gfriloux/jardin/docs/src/content/docs/objectifs/o5-chaine-de-donnees.md

---
title: O5 — La chaîne de données
description: De la liaison série à Grafana, en passant par une archive brute et MariaDB.
sidebar:
  order: 5
  badge:
    text: Prêt
    variant: note
---

**La question.** Est-ce que l'architecture de données est agréable à exploiter ?

**Critère de sortie.** Quatre choses, toutes vérifiables en une séance :

1. une trame partie de la radio arrive dans Grafana, rattachée à son point de
   mesure et à sa zone ;
2. l'index se reconstruit **entièrement** depuis l'archive par simple réimport ;
3. la chaîne survit à ce qui va lui arriver — nœud muet, ligne d'archive
   illisible, collecteur relancé, changement de mois ;
4. les quatre questions ouvertes ci-dessous sont tranchées.

**Dépend de.** [O3](/objectifs/o3-calibration/) et
[O4](/objectifs/o4-lien-radio/) · **Débloque.**
[O6](/objectifs/o6-autonomie/)

:::note[Le critère demandait « une semaine de mesures ». Il ne le demande plus]
La formulation initiale datait d'avant que la chaîne existe : une semaine de
données servait de preuve indirecte que tout tenait ensemble. Maintenant que
tout a tourné, elle ne prouverait plus grand-chose.

**Ce que la semaine aurait apporté** tient en trois points, et aucun ne vaut
sept jours : que le collecteur tienne dans la durée — 48 h le montrent aussi
bien ; la bascule de fichier d'archive au changement de mois — qui arrive de
toute façon ; et du volume — dont MariaDB ne s'apercevra pas.

**Ce qu'elle n'aurait pas apporté**, en revanche, est précisément ce que O5
cherche. Les sondes sont sur une table, l'une dans un verre d'eau : une semaine
de ça produit une ligne plate, et on n'exploite pas une ligne plate. La question
« cette architecture est-elle agréable à exploiter » a besoin de données qui
disent quelque chose, pas de données nombreuses.

**La semaine de mesures réelles est donc déplacée dans
[O7](/objectifs/o7-mise-au-jardin/)**, où les sondes seront en terre. Elle n'y
coûte rien de plus — c'est ce que O7 fait de toute façon — et elle y produira
enfin une courbe d'assèchement, qui est ce dont [O8](/objectifs/o8-exploitation/)
a besoin.

Reste que les quatre questions ouvertes de cet objectif sont toutes des
questions de **conception**, et qu'aucune ne se répond en attendant.
:::

## La chaîne

```mermaid
flowchart LR
    N["NODE-001"] -->|LoRa| G["GATEWAY-001"]
    G -->|USB série| C["collecteur<br/>(Rust)"]
    C -->|append-only| F["data/*.ndjson<br/><b>source de vérité</b>"]
    F --> I["importeur<br/>(même binaire)"]
    I --> DB["MariaDB"]
    DB --> V["Grafana"]
```

Le point important est le **découplage par l'archive** : le nœud ne sait rien
du serveur, le collecteur ne sait rien de SQL, et la base ne sait rien de LoRa.
Chacun peut être remplacé sans toucher aux autres.

L'archive est le point de synchronisation, et elle est la seule pièce dont la
perte serait irréparable.

## Le collecteur

Un binaire Rust — voir [ADR-006](/decisions/#adr-006--collecteur-en-rust) — avec
deux sous-commandes, et des responsabilités volontairement étroites.

`collect` :

1. lire les lignes de `GATEWAY-001` sur le port série ;
2. **horodater** à la réception (le nœud n'a pas d'horloge fiable) ;
3. écrire en append-only dans `data/AAAA-MM/NODE-XXX.ndjson`.

C'est tout. Il ne connaît ni SQL ni MQTT : il sait écrire des lignes.

`import` :

4. relire l'archive et alimenter MariaDB, de façon **idempotente** — rejouer
   toute l'archive ne crée aucun doublon.

La calibration n'est appliquée nulle part : elle est calculée à la lecture par
une vue SQL. Voir [ADR-012](/decisions/#adr-012--larchive-ndjson-est-le-bus-mqtt-sort-du-chemin-principal).

### `collect` ne comprend pas ce qu'il transporte

C'est délibéré, et c'est le point de conception le plus important du collecteur.
Il valide que la ligne est du JSON, en extrait `frame.node` pour choisir le
fichier, et **recopie tout le reste sans l'interpréter**. Le jour où le firmware
ajoutera un champ, celui-ci traversera l'archive intact au lieu d'être
silencieusement perdu.

Trois propriétés qui en découlent, toutes vérifiées par des tests :

- les entiers restent entiers — `1834`, jamais `1834.0` ;
- le bruit de démarrage de la carte (`ets Jul 29 2019…`) est signalé et ignoré,
  sans interrompre la collecte ;
- le nom du nœud est **filtré avant de servir de nom de fichier**. Le nœud
  contrôle cette chaîne : une trame annonçant `"node": "../../etc/cron.d/x"`
  ferait sinon écrire le collecteur hors de son répertoire.

Chaque ligne est vidée sur disque immédiatement. À quelques trames par minute,
le coût est nul, et une coupure de courant ne fait pas perdre le tampon.

### `import` est rejouable

Deux mécanismes complémentaires :

- un **repère d'avancement** par fichier (`import_state`), pour reprendre où on
  s'est arrêté plutôt que de tout relire ;
- l'**unicité de `(source_file, source_line)`**, qui garantit qu'une ligne déjà
  connue ne peut pas être insérée deux fois, même si le repère est faux.

`--rejouer` efface les repères et relit toute l'archive : l'opération est sans
effet de bord, et c'est ce qui rend la base jetable.

Un nœud inconnu est **créé automatiquement**, avec un libellé explicite. Refuser
la trame ferait perdre des mesures parce que le matériel n'a pas encore été
déclaré ; `v_current_wiring` montrera ses voies sans sonde attachée, ce qui est
le rappel qu'il reste à le faire.

### D'où vient le type d'une mesure

La trame ne le transporte pas : le nœud émet `"soil-01": 1834`, sans dire ce que
c'est. La table `channel_convention` fait la correspondance par préfixe, le plus
long l'emportant :

```text
soil-      → soil_moisture / raw
soiltemp-  → soil_temperature / degC
battery    → voltage / V
```

Déclaratif plutôt que codé en dur : ajouter un type ne demande pas de
recompiler. Et indépendant des déclarations de matériel, donc les mesures
rentrent même avant qu'on ait déclaré quoi que ce soit.

## Le contrôle de fin d'objectif

```console
$ just db-wiring
+----------+---------+--------------------------+------------------+-----------+----------+
| node_uid | channel | point_label              | measurement_type | zone_uid  | depth_cm |
+----------+---------+--------------------------+------------------+-----------+----------+
| NODE-001 | soil-01 | Fraisiers — humidité 1   | soil_moisture    | FRAISIERS |     NULL |
| NODE-001 | soil-02 | Fraisiers — humidité 2   | soil_moisture    | FRAISIERS |     NULL |
| NODE-001 | soil-03 | Fraisiers — humidité 3   | soil_moisture    | FRAISIERS |     NULL |
+----------+---------+--------------------------+------------------+-----------+----------+
```

Trois voies, trois libellés, une zone — et les mesures qui s'y rattachent dans
Grafana comme dans l'archive. `depth_cm` reste vide tant que rien n'est en
terre : c'est [O7](/objectifs/o7-mise-au-jardin/) qui le remplira.

## Le simulateur de nœud

Écrit avant le collecteur, et volontairement : il permet d'éprouver toute la
chaîne serveur **sans matériel**.

```console
$ just sim-serie        # un port série virtuel sur /tmp/jardin-gateway
$ just sim-archive 21   # trois semaines d'historique dans l'archive
```

Le but n'est pas de jouer, c'est de **découpler les pannes**. Si la chaîne
serveur est prouvée avec des données synthétiques, alors le jour où le matériel
arrive, ce qui casse est forcément le matériel ou le firmware — on ne débogue
plus deux inconnues à la fois, une carte neuve dans les mains.

Il reproduit ce qu'on cherchera réellement à observer, plutôt que des nombres au
hasard :

| Phénomène | Pourquoi il compte |
|---|---|
| Assèchement exponentiel, arrosages espacés | la forme des courbes de [O8](/objectifs/o8-exploitation/) |
| **Dispersion inter-sondes** (±8 % sur les bornes sec/saturé) | reproduit la découverte que [O3](/objectifs/o3-calibration/) doit faire |
| Effet de profondeur : la couche à 20 cm réagit moins et plus tard | l'observation qui motive deux profondeurs par zone |
| Oscillation thermique jour/nuit | l'effet qui justifiera une sonde de température |
| Trames perdues, trous dans `seq` | de quoi mesurer un taux de perte |
| Lignes parasites de démarrage (`ets Jul 29 2019…`) | ce qui fait planter un parseur naïf |
| Redémarrages, `seq` qui repart à 0 | à détecter côté collecteur |

Une implémentation **indépendante** du collecteur, en Python : elle ne partage
pas ses hypothèses, ce qui est précisément ce qui rend le test valable.

Les parasites n'existent que sur la liaison série — l'archive, elle, ne contient
que des trames valides. C'est une propriété du collecteur, et le simulateur la
respecte pour ne pas donner un faux sentiment de robustesse à l'importeur.

## Le tableau de bord

Provisionné par fichier — `stack/grafana/provisioning/dashboards/` — donc
versionné avec le reste. Il apparaît tout seul au démarrage de la stack, sans
rien cliquer.

Six panneaux, chacun répondant à la question d'un objectif :

| Panneau | Ce qu'il sert à voir |
|---|---|
| **Nœuds** | âge de la dernière trame, taux de perte, RSSI, batterie. Une ligne par carte |
| **Valeur brute d'ADC** | ce qui est réellement stocké. La valeur **descend** quand l'humidité monte |
| **Humidité calibrée** | la même chose interprétée. Reste vide tant que [O3](/objectifs/o3-calibration/) n'a pas produit de calibration |
| **Écart entre sondes de même profondeur** | la question de O3 : ce qui reste après regroupement par profondeur est la dispersion propre des sondes |
| **Qualité du lien radio** | RSSI et SNR, pour [O4](/objectifs/o4-lien-radio/) et [O7](/objectifs/o7-mise-au-jardin/) |
| **Tension d'alimentation** | peu informative sur powerbank, elle le deviendra à [O6](/objectifs/o6-autonomie/) |

Le taux de perte est estimé par les trous dans le compteur de séquence, **en
excluant les redémarrages** — un `seq` qui repart à 0 n'est pas une perte.

:::caution[Le fuseau horaire, piège silencieux]
Le collecteur horodate en UTC et les colonnes `DATETIME` ne portent pas de
fuseau. La source de données Grafana doit donc annoncer **`timezone: UTC`** :
y mettre `Europe/Paris` décale tout l'historique de deux heures en été, sans
aucun message d'erreur. L'affichage dans le fuseau local est le travail du
tableau de bord, pas de la source de données.
:::

**Pour expérimenter** : le fichier fait foi, l'interface ne peut pas
l'écraser. « Save as » crée une copie où tinkerer librement ; ce qui mérite
d'être gardé se reporte dans le JSON versionné.

## Pourquoi une archive en plus de la base

Une ligne JSON par trame, jamais réécrite, dans le format le plus bête possible.
C'est précisément parce qu'il est bête qu'il survivra à tous les changements de
base de données.

La base sert à **regarder et interroger**. L'archive sert à **survivre** : elle
permet de reconstruire l'index de zéro, et de rejouer tout l'historique après un
changement de calibration.

## La stack

Base, visualisation, collecteur et importeur sont décrits dans un seul
`stack/compose.yaml` — voir
[ADR-011](/decisions/#adr-011--la-stack-serveur-est-un-jeu-de-conteneurs).

```console
$ just stack-up            # MariaDB + Grafana
$ just db-wiring           # quelle sonde est branchée où
```

Grafana écoute alors sur `http://localhost:3000`, avec sa source de données déjà
provisionnée. Le collecteur et l'importeur s'ajoutent avec
`just stack-up-collector` quand ils existeront — un profil Compose les tient à
l'écart d'ici là, comme Home Assistant, conservé sous le profil `ha` pour
[O9](/objectifs/o9-irrigation/).

L'intérêt de cette forme est qu'elle ne préjuge pas de la machine : le même
fichier tournera sur le poste aujourd'hui, sur un Raspberry Pi cet hiver. La
question « où héberger » devient un choix d'exploitation, pas d'architecture.

:::caution[Le port série dans un conteneur]
C'est la seule vraie contrainte que la conteneurisation introduit. Le
collecteur a besoin de `devices:` sur la passerelle USB — et surtout d'un **nom
de périphérique stable**, sans quoi `/dev/ttyUSB0` devient `/dev/ttyUSB1` au
premier rebranchement et le conteneur refuse de démarrer. La règle udev est
dans `stack/README.md`.
:::

Conséquence assumée pendant le POC : pas de mesures quand le poste est éteint.

## Questions ouvertes

- L'importeur doit-il tourner en continu (`--follow`) ou par lot périodique ?
- Comment détecter proprement qu'un nœud est muet — un délai fixe, ou un
  multiple de sa période d'émission annoncée ?
- Que fait l'importeur d'une ligne d'archive illisible : il l'ignore et
  poursuit, ou il s'arrête ?
- Faut-il un tableau de bord Grafana provisionné par fichier, ou construit à la
  main puis exporté ?

## Résultats

*À remplir.*
