gfriloux/jardin/docs/src/content/docs/projet/feuille-de-route.md

---
title: Feuille de route
description: Le graphe des dix objectifs, du premier octet lu sur l'ADC jusqu'aux électrovannes.
sidebar:
  order: 2
---

Le projet avance par **objectifs numérotés**. Chacun a un critère de sortie
vérifiable : tant qu'il n'est pas atteint, on n'attaque pas le suivant. Un
objectif n'est pas une liste de tâches, c'est une **question à laquelle on veut
une réponse**.

## Le graphe

```mermaid
flowchart TD
    O0["<b>O0 — Socle projet</b><br/>dépôt, devshell Nix, doc"]
    O1["<b>O1 — Une sonde, une valeur</b><br/>ADC brut lisible sur la liaison série"]
    O2["<b>O2 — Passer à N sondes</b><br/>CD74HC4067, au-delà de quatre sondes"]
    O3["<b>O3 — Calibration</b><br/>sec / humide / saturé, dérive inter-sondes"]
    O4["<b>O4 — Le lien radio</b><br/>LoRa point-à-point NODE → GATEWAY"]
    O5["<b>O5 — La chaîne de données</b><br/>archive NDJSON → MariaDB → Grafana"]
    O6["<b>O6 — Autonomie</b><br/>deep sleep, conso, batterie, solaire"]
    O7["<b>O7 — Mise au jardin</b><br/>boîtier, câbles longs, portée réelle"]
    O8["<b>O8 — Exploitation</b><br/>courbes d'assèchement, seuils, alertes"]
    O9["<b>O9 — Irrigation</b><br/>électrovannes, boucle de commande"]

    O0 --> O1
    O1 --> O2
    O1 --> O3
    O3 -.->|référence de validation| O2
    O1 --> O4
    O4 --> O5
    O3 --> O5
    O5 --> O6
    O6 --> O7
    O7 --> O8
    O8 --> O9

    subgraph POC["POC — sur la table"]
        O1
        O2
        O3
        O4
        O5
    end
    subgraph V1["V1 — dehors, en permanence"]
        O6
        O7
        O8
    end
    subgraph V2["V2 — plus tard"]
        O9
    end
```

Trois choses à lire dans ce graphe :

- **O1 débloque O4 directement.** Le lien radio n'attend pas le multiplexage ni
  la calibration : une seule sonde suffit à valider la portée. Ces deux branches
  peuvent avancer en parallèle si le matériel le permet.
- **O3 ne dépend plus de O2**, et la flèche s'est même inversée en pointillés.
  ADC1 laisse quatre broches libres une fois la batterie et l'alimentation des
  sondes câblées : les trois sondes du POC tiennent en direct. Mesurer leur
  divergence *à travers* un multiplexeur empêcherait d'ailleurs de distinguer
  la dispersion des sondes de celle des canaux. Ces mesures directes sont au
  contraire la **référence contre laquelle O2 se validera** — c'est
  littéralement son critère de sortie.
- **O5 attend O3 *et* O4.** Stocker des mesures non calibrées est possible — et
  c'est même ce qu'on fait, la calibration étant calculée à la lecture. Mais on
  veut que la première série de données archivée soit déjà attribuable et
  interprétable.

## Les objectifs en une ligne

| # | Objectif | Question à laquelle il répond | État |
|---|---|---|---|
| [O0](/objectifs/o0-socle/) | Socle projet | Où vit le code, comment on le construit, où on documente ? | ✅ tenu |
| [O1](/objectifs/o1-une-sonde/) | Une sonde, une valeur | Est-ce qu'une sonde donne une valeur stable et plausible ? | ✅ tenu |
| [O2](/objectifs/o2-multiplexage/) | Passer à N sondes | Est-ce qu'un nœud peut lire plus de quatre sondes sans se mélanger ? | ✅ tenu |
| [O3](/objectifs/o3-calibration/) | Calibration | Que vaut réellement un nombre d'ADC ? | ✅ tenu |
| [O4](/objectifs/o4-lien-radio/) | Le lien radio | Est-ce que LoRa porte depuis le fond du jardin ? | ✅ tenu |
| [O5](/objectifs/o5-chaine-de-donnees/) | La chaîne de données | Est-ce que l'architecture de données est agréable à exploiter ? | 🔜 prêt |
| [O6](/objectifs/o6-autonomie/) | Autonomie | Combien de temps le nœud tient-il, et sur quelle source ? | ⏸ bloqué |
| [O7](/objectifs/o7-mise-au-jardin/) | Mise au jardin | Est-ce que ça survit dehors, avec 15 m de câble ? | ⏸ bloqué |
| [O8](/objectifs/o8-exploitation/) | Exploitation | Qu'est-ce que le sol raconte, et quand faut-il arroser ? | ⏸ bloqué |
| [O9](/objectifs/o9-irrigation/) | Irrigation | Peut-on fermer la boucle sans noyer les fraisiers ? | ⏸ bloqué |

## Les quatre questions du POC

Les objectifs O1 à O5 existent pour répondre à quatre questions, et à rien
d'autre :

1. ✅ Est-ce que les sondes donnent des mesures suffisamment **stables** ?
2. ✅ Est-ce qu'un nœud peut lire **plusieurs sondes** ? — seize canaux
   adressables, et un multiplexeur qui décale de moins de 2 points
3. ✅ Est-ce que **LoRa porte** correctement depuis le jardin ? — oui, et de
   très loin : 0 % de perte à 15 m, 60 dB de marge
   ([résultats](/objectifs/o4-lien-radio/#résultats))
4. ⬜ Est-ce que l'**architecture de données** est agréable à exploiter ?

Tout ce qui ne sert pas à répondre à l'une de ces quatre questions est du
travail reporté à la V1.

Trois des quatre sont donc closes. **La dernière est le seul chantier restant
du POC** : la chaîne a tourné de bout en bout, il lui reste à prouver qu'elle
encaisse les incidents — nœud muet, ligne d'archive illisible, collecteur
relancé.

## La progression du montage

Le nœud grossit par paliers, chacun correspondant à un objectif :

```mermaid
flowchart LR
    subgraph V00["V0.0 — O1"]
        A1[Heltec] --- A2[sonde 1]
    end
    subgraph V01["V0.1 — O3"]
        B1[Heltec] --- B3["S1 S2 S3<br/>en direct sur ADC1"]
    end
    subgraph V02["V0.2 — O4/O5"]
        C1["NODE-001<br/>mesure + seq + batterie"] -->|LoRa| C2[GATEWAY-001] -->|USB| C3[collecteur] -->|NDJSON| C4[MariaDB]
    end
    subgraph V03["V0.3 — O2"]
        D1[Heltec] --- D2[MUX] --- D3["jusqu'à 16 sondes"]
    end

    V00 --> V01 --> V02 --> V03
```

## Ce qui n'est pas dans le graphe

Trois chantiers transverses avancent en continu, sans objectif dédié :

- **la documentation** — chaque objectif atteint produit sa page ;
- **les décisions** — consignées au fil de l'eau dans les
  [ADR](/decisions/), y compris celles qu'on revient dessus ;
- **les mesures elles-mêmes** — dès O1, toute série de mesures est archivée,
  même celles ratées. Une sonde qui dérive est une donnée, pas un échec.
