gfriloux/jardin/docs/src/content/docs/projet/modele-de-donnees.md

---
title: Modèle de données
description: La trame radio, l'archive NDJSON et le schéma SQL — cartes LoRa, points de mesure, zones, et le câblage daté qui les relie.
sidebar:
  order: 4
---

## La chaîne

```mermaid
flowchart LR
    N["NODE-001<br/>trame LoRa"] -->|radio| G["GATEWAY-001"]
    G -->|USB série| C["collecteur"]
    C -->|append-only| A["archive NDJSON<br/><b>source de vérité</b>"]
    A --> I["importeur"]
    I --> DB["MariaDB<br/><i>index dérivé</i>"]
    DB --> V["Grafana"]
```

L'archive est le point de synchronisation. Le collecteur ne connaît ni SQL ni
MQTT : il sait écrire des lignes. L'importeur relit l'archive et alimente la
base — **rejouable de bout en bout**, ce qui rend la base jetable.

## Le tuple canonique

Tout ce qui traverse le système se réduit à :

```text
node_id  channel    timestamp             measurement_type  value   unit
─────────────────────────────────────────────────────────────────────────
NODE-001 soil-01    2026-08-20T12:00:00Z  soil_moisture     1834    raw
NODE-001 soil-02    2026-08-20T12:00:00Z  soil_moisture     1921    raw
NODE-001 battery    2026-08-20T12:00:00Z  voltage           4.87    V
```

La deuxième colonne est une **voie**, pas une sonde : `soil-01` est une prise
sur la carte, pas l'objet qui y est branché.

Le mot « humidité » n'apparaît **pas** dans le protocole. `soil_moisture` est
une valeur de `measurement_type` parmi d'autres, et son `unit` reste `raw` tant
qu'aucune calibration n'a été appliquée.

## Qui horodate

Le nœud **n'horodate pas**. Il n'a ni RTC ni source de temps fiable après un
deep sleep de plusieurs heures. Il émet un **compteur de séquence** monotone ;
le collecteur horodate à la réception et conserve `seq`, ce qui permet de
détecter a posteriori les paquets perdus et les redémarrages du nœud.

## La trame radio

Lisible, pour le POC :

```json
{
  "node": "NODE-001",
  "seq": 182,
  "battery": 4.87,
  "sensors": { "soil-01": 623, "soil-02": 581, "soil-03": 704 }
}
```

:::note[À réoptimiser plus tard]
LoRa impose un rapport cyclique (1 % en EU868 sur la plupart des sous-bandes) et
un temps d'antenne qui croît avec la taille du paquet. Une trame binaire compacte
deviendra nécessaire quand le nombre de nœuds augmentera — pas avant.
:::

## La distinction qui structure tout le schéma

Deux objets déclarés, et une chose qu'on ne déclare **pas** :

| Objet | Ce que c'est |
|---|---|
| **node** | une carte LoRa. Elle émet son identifiant. |
| **measurement_point** | une voie de mesure : ce qui est branché sur `NODE-001/soil-01`, comment ça s'appelle à l'écran, et dans quelle zone ça se trouve. |
| ~~sensor~~ | **rien.** La sonde n'est pas un objet suivi — voir [ADR-017](/decisions/#adr-017--on-déclare-des-points-de-mesure-pas-des-sondes). |

`NODE-001/soil-01` et `NODE-002/soil-01` sont deux voies différentes, et chacune
peut changer de zone ou de rôle dans le temps. D'où une **table datée** plutôt
qu'une clé étrangère directe.

```mermaid
erDiagram
    node ||--o{ measurement_point : "porte"
    zone ||--o{ measurement_point : "contient"
    measurement_point ||--o{ calibration : "est calibré par"
    node ||--o{ frame : "émet"
    frame ||--o{ measurement : "porte"
```

Les tables de faits — `frame` et `measurement` — **ne référencent aucun point**.
Une trame ne connaît que des voies. L'attribution se fait **à la lecture**, par
jointure temporelle.

C'est ce qui permet de recâbler sans réécrire une seule ligne d'historique :

```text
NODE-001 / soil-01, mesure du 20 août  →  « Fraisiers — humidité », zone FRAISIERS
NODE-001 / soil-01, mesure du 5 sept.  →  « Potager — humidité »,   zone POTAGER
```

Les deux restent correctement attribuées, pour toujours.

:::note[Le type de mesure ne se déclare pas ici]
Il se déduit du **nom de la voie**, via la table `channel_convention` :
`soil-` donne `soil_moisture`, `battery` donne `voltage`, le préfixe le plus
long l'emportant. C'est le nom que le nœud émet qui porte l'information.

Le redéclarer sur le point de mesure créerait deux sources de vérité capables
de diverger sans que rien ne le signale.
:::

## Les zones

Une zone est une **décision du jardinier** — une planche, une rangée, un pied
d'arbre — pas un calcul. C'est ce qui correspond à l'action réelle : une
électrovanne arrose une zone, pas un point.

Le polygone est en **repère local, en mètres**. Pas de latitude/longitude : pour
un jardin, la courbure de la Terre n'intervient pas, et un repère métrique rend
les distances directement lisibles.

### Le repère

Un GPS grand public est précis à 3–5 m près. L'allée de fraisiers fait 15 m
sur 0,5 m : le GPS placerait la sonde quelque part dans un cercle englobant
toute l'allée. Un mètre ruban est précis au centimètre.

Le repère est donc **local**, défini par trois choses à figer une fois pour
toutes :

1. **une origine** qui ne bougera pas — un angle de bâtiment, un poteau scellé.
   Pas un pot de fleurs ;
2. **une direction pour l'axe X**, alignée sur quelque chose de physique ;
3. **l'unité : le mètre**, l'axe Y à 90° dans le sens direct.

`POINT(7 3)` se lit alors « 7 m le long de l'axe, 3 m en s'en écartant ».

:::tip[Le nord en haut n'a aucune raison d'être le repère]
C'est une convention de cartographie, pas une contrainte. Aligner l'axe X sur
une limite de terrain ou sur un mur donne un plan où tout est droit, et des
coordonnées qu'on lit sans transposer.
:::

### Le fond de plan

Pas besoin de photo satellite — inutilisable de toute façon si des arbres
masquent une partie du terrain — ni d'une capture d'écran du cadastre, limitée
en zoom. Le cadastre est disponible en **vecteur** via l'API carto de l'IGN :

Les trois identifiants se lisent sur
[cadastre.gouv.fr](https://www.cadastre.gouv.fr/) : le code INSEE de la commune,
la section, et le numéro de parcelle.

```console
$ ./tools/plan-parcelle.py --insee <insee> --section <section> --numero <numero> \
      --out docs/src/assets/plan/parcelle.svg
Parcelle du terrain — 19 sommets
  emprise  28.6 x 34.0 m
  surface  855 m2 calcules / 860 m2 au cadastre
  rotation 112.1 deg — le nord pointe dans cette direction
```

L'outil récupère le contour, le convertit en mètres, et **le fait pivoter pour
aligner sa plus longue limite sur l'axe X**. Il vérifie au passage sa propre
conversion en comparant la surface calculée à la contenance cadastrale.

<figure class="plan">
<svg xmlns="http://www.w3.org/2000/svg" viewBox="0 0 484 560"
     role="img" aria-label="Parcelle du terrain">
  <g class="grille"><line class="grid grid--major" x1="0.0" y1="0" x2="0.0" y2="559.6"/><line class="grid" x1="14.0" y1="0" x2="14.0" y2="559.6"/><line class="grid" x1="28.0" y1="0" x2="28.0" y2="559.6"/><line class="grid" x1="42.0" y1="0" x2="42.0" y2="559.6"/><line class="grid" x1="56.0" y1="0" x2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
  <polygon class="parcelle" points="414.5,517.6 347.2,506.2 157.4,472.5 119.8,464.5 111.7,461.9 102.1,457.0 91.6,450.0 82.6,442.3 73.6,431.9 67.2,422.1 61.3,410.5 56.7,396.8 54.3,381.6 52.6,367.4 50.3,297.8 48.7,240.4 42.0,42.0 442.4,42.0 435.7,152.5"/>
  <g class="reperes"><text class="tick" x="42.0" y="555.6" text-anchor="middle">0</text><text class="tick" x="112.0" y="555.6" text-anchor="middle">5</text><text class="tick" x="182.0" y="555.6" text-anchor="middle">10</text><text class="tick" x="252.0" y="555.6" text-anchor="middle">15</text><text class="tick" x="322.0" y="555.6" text-anchor="middle">20</text><text class="tick" x="392.0" y="555.6" text-anchor="middle">25</text><text class="tick" x="6" y="521.6">0</text><text class="tick" x="6" y="451.6">5</text><text class="tick" x="6" y="381.6">10</text><text class="tick" x="6" y="311.6">15</text><text class="tick" x="6" y="241.6">20</text><text class="tick" x="6" y="171.6">25</text><text class="tick" x="6" y="101.6">30</text></g>
  <g class="nord" transform="translate(442,42)">
    <line x1="0" y1="0" x2="20.4" y2="8.3"/>
    <circle cx="0" cy="0" r="2.5"/>
    <text x="30.6" y="16.4" text-anchor="middle">N</text>
  </g>
  <text class="echelle" x="8" y="16">graduations en mètres · repère local</text>
</svg>
<figcaption>Parcelle du terrain, repère local aligné sur la limite la plus longue.
Graduations en mètres, majeures tous les 5 m.</figcaption>
</figure>

:::caution[Ne jamais versionner les identifiants cadastraux]
Code INSEE, section et numéro de parcelle désignent **exactement** un terrain, et
l'API carto de l'IGN est ouverte à tous : les inscrire dans la documentation
revient à publier son adresse. C'est pourquoi les exemples de cette page portent
des marqueurs et non des valeurs.

Passe les tiens en ligne de commande, une fois, au moment de générer le SVG.
Ils n'ont aucune raison d'entrer dans le dépôt.
:::

:::note[Le SVG produit, lui, est anonyme]
Il ne contient que des **mètres relatifs à un coin du terrain** — aucune
latitude, aucune longitude. Il peut donc être versionné et publié. Les
paramètres de transformation, origine réelle et rotation, n'ont pas à être
conservés : le repère local se suffit à lui-même.

Restent la **forme du polygone et sa surface**, qui sont en théorie
rapprochables du cadastre par comparaison géométrique. C'est un travail
autrement plus coûteux que de lire trois identifiants, et on l'assume — mais
autant le savoir.
:::

:::caution[Ne pas confondre zones et interpolation]
La tentation est d'estimer un champ continu d'humidité entre les sondes, façon
carte météo. Mais le champ **n'est pas continu** : type de sol, exposition,
couvert végétal, pente et tassement font que deux sondes à 5 m peuvent
légitimement diverger sans gradient entre elles. Interpoler y inventerait des
valeurs plausibles et fausses.

L'appartenance à une zone est donc déclarée, pas déduite. La position ne sert
qu'à la carte — une vue `v_placement_anomalies` signale les positions qui
tombent hors de leur zone déclarée, sans rien interdire.
:::

## Les vues

On n'interroge jamais `measurement` directement.

| Vue | Ce qu'elle donne |
|---|---|
| `v_measurement` | chaque mesure, avec la sonde, la profondeur et la zone **en vigueur au moment de la mesure** |
| `v_soil_moisture` | idem, plus la valeur calibrée calculée à la volée |
| `v_current_wiring` | quelle sonde est branchée où, en ce moment |
| `v_placement_anomalies` | les positions incohérentes avec leur zone |

La calibration n'est **jamais écrite** dans les données. La corriger recalcule
tout l'historique, sans migration — c'est la promesse de
[ADR-002](/decisions/#adr-002--on-stocke-la-valeur-adc-brute), tenue par une
vue plutôt que par du code.

## Les garde-fous

SQL ne sait pas exprimer déclarativement « ces intervalles ne se chevauchent
pas ». Or un chevauchement ne produirait aucune erreur : la jointure temporelle
rendrait deux lignes au lieu d'une, et les mesures seraient dupliquées **en
silence**. Des déclencheurs l'interdisent :

| Garde-fou | Effet |
|---|---|
| Deux sondes sur la même voie au même moment | refusé |
| Une sonde branchée à deux endroits au même moment | refusé |
| Deux implantations simultanées pour une sonde | refusé |
| Réimport de la même ligne d'archive | refusé — l'import est idempotent |
| Type de mesure inconnu (faute de frappe) | refusé par clé étrangère |

L'unicité sur `(source_file, source_line)` est ce qui rend le réimport sûr :
rejouer toute l'archive ne crée aucun doublon.

## Persistance

| Quoi | Rôle | Où |
|---|---|---|
| Archive NDJSON | **source de vérité**, append-only, jamais réécrite | `stack/data/`, en clair sur l'hôte |
| MariaDB | index dérivé, requêtable | volume Docker |
| Grafana | visualisation | volume Docker |

L'archive est délibérément **hors volume Docker** : elle doit survivre à un
`docker compose down -v` distrait, et rester sauvegardable avec un simple `cp`.

## Déclarer son câblage

Rien n'est découvert automatiquement : les nœuds, les zones et les points de
mesure se déclarent à la main, dans
`stack/mariadb/schema/006-declarations.sql`.

Ce fichier vit dans `docker-entrypoint-initdb.d` pour une raison précise :
c'est la **seule** partie de la base qui ne se reconstruit pas depuis l'archive
NDJSON. Ailleurs, un `just db-reset` effacerait des déclarations qu'aucun
réimport ne pourrait rejouer, et les mesures redeviendraient orphelines archive
intacte.

:::tip[La règle de survie]
Pour recâbler une voie : **ne jamais modifier la ligne existante**. On la
**clôt** (`valid_to`) et on en ouvre une nouvelle. Modifier réattribuerait tout
l'historique, rétroactivement et sans le dire.
:::

En revanche, **remplacer une sonde morte ne demande rien**. C'est la même voie,
au même endroit, qui mesure la même chose : aucune ligne de SQL, aucune
étiquette à coller. On change un pneu sans le baptiser — voir
[ADR-017](/decisions/#adr-017--on-déclare-des-points-de-mesure-pas-des-sondes).
