gfriloux/jardin/docs/src/content/docs/objectifs/o8-exploitation.md

---
title: O8 — Exploitation
description: Lire ce que le sol raconte, et en tirer des seuils défendables.
sidebar:
  order: 8
---

**La question.** Qu'est-ce que le sol raconte, et à partir de quand faut-il
arroser ?

**Critère de sortie.** Une saison de données, des courbes d'assèchement par
zone, et un seuil d'arrosage justifié par ces courbes plutôt que choisi
arbitrairement.

**Dépend de.** [O7](/objectifs/o7-mise-au-jardin/) · **Débloque.**
[O9](/objectifs/o9-irrigation/)

## Ce qu'on cherche à voir

La forme de base, celle qui a motivé tout le projet :

```text
humidité
  │
80│          ╭──────╮
60│──────────╯      ╰─────╮
40│                       ╰────
20│
  └───────────────────────────── temps
       arrosage ↑
```

Ce qui est intéressant n'est pas le niveau, c'est la **pente de la descente**.
C'est elle qui dit combien de temps le sol tient, et donc quand il faudra
revenir.

## Les questions auxquelles les données doivent répondre

- **Vitesse d'assèchement par zone.** « La zone A reste humide 36 h alors que la
  zone B sèche en 18 h » — deux zones qui sèchent à des vitesses différentes ne
  doivent pas être arrosées au même rythme.
- **Efficacité réelle d'un arrosage.** L'eau descend-elle à 20 cm, ou
  ruisselle-t-elle en surface ? La comparaison des deux profondeurs répond
  directement, et c'est souvent une mauvaise surprise.
- **Effet d'une canicule.** Quelle pente pendant un épisode à 40 °C, comparée à
  une semaine ordinaire ? C'est la question d'origine du projet.
- **Effet de la pluie.** Combien de millimètres pour réellement recharger le sol
  — et à partir de quand une pluie annoncée dispense d'arroser.
- **Dérive des sondes.** Une sonde qui s'éloigne lentement des autres sans
  raison physique est en train de mourir. Le détecter tôt évite d'arroser sur
  la foi d'un capteur défaillant.

## Le seuil

C'est le livrable de cet objectif, et il ne peut pas être posé plus tôt.

Un seuil brut sur la valeur instantanée est fragile : il déclenchera un
arrosage à la première fluctuation de température. Ce qui marche en général :

- un seuil sur une **moyenne glissante**, pas sur la mesure brute ;
- une **hystérésis** — on déclenche à un niveau, on arrête à un autre ;
- une **profondeur de référence** : la couche à 20 cm dit mieux l'état réel des
  racines que la surface, qui sèche et se remouille sans arrêt.

## L'outillage

L'exploration se fait en SQL sur MariaDB, via les vues qui rattachent chaque
mesure à sa sonde et à sa zone — voir
[le modèle de données](/projet/modele-de-donnees/#les-vues). L'archive NDJSON
reste dessous : si une requête révèle qu'il manque une colonne, on la rejoue.

C'est aussi ici que se décidera l'interface : la carte du jardin avec les zones
n'a de sens qu'à partir du moment où il y a assez de sondes pour que les zones
en aient un. Voir [ADR-014](/decisions/#adr-014--grafana-dabord-interface-maison-différée).

## Questions ouvertes

- Quel indicateur exactement : valeur instantanée, moyenne glissante, ou pente ?
- Faut-il corriger de la température du sol, et cela suppose-t-il d'ajouter une
  sonde de température ? *(venue de [O3](/objectifs/o3-calibration/) : l'effet
  d'un cycle jour/nuit d'août n'est pas mesurable sur une table, il se lira dans
  les premières données continues. Il compte, parce qu'une dérive thermique qui
  ferait passer la valeur sous le seuil déclencherait un arrosage inutile.)*
- Un seuil unique pour tout le terrain, ou un par zone ?
- Quelles alertes valent la peine — sonde muette, batterie basse, dérive
  anormale ?

## Résultats

*À remplir.*
