gfriloux/jardin/firmware/include/board.h

#pragma once

// Brochage de la carte : Heltec WiFi LoRa 32 (V3), ESP32-S3 + SX1262.
//
// ATTENTION : la carte du projet est un clone (Heemol SX1262 LoRa V3). Ces
// valeurs sont celles documentées par Heltec pour la V3 ; elles sont à
// confirmer sur le clone. C'est précisément ce que vérifient les croquis
// 02-oled et 03-radio. Si l'un des deux échoue, c'est ici — et seulement
// ici — qu'il faut corriger.

// --- Écran OLED SSD1306 128 x 64, en I2C ---
#define PIN_OLED_SDA 17
#define PIN_OLED_SCL 18
#define PIN_OLED_RST 21

// --- Alimentation des périphériques de la carte (dont l'écran) ---
// ACTIF À L'ÉTAT BAS : digitalWrite(PIN_VEXT, LOW) met sous tension.
//
// Le guide GPIO de Heltec annonce GPIO 33 à 38 comme réservés au SPI Flash /
// SubSPI. C'est vrai du chip ESP32-S3 en configuration octale ; la V3 utilise
// une flash quad, ce qui libère 36 et 37 pour la carte elle-même. D'où cette
// affectation, qui contredit la lecture rapide du guide sans la contredire
// vraiment. Le croquis 02-oled tranche.
#define PIN_VEXT 36

// --- LED utilisateur ---
#define PIN_LED 35

// --- Radio LoRa SX1262, en SPI ---
#define PIN_LORA_NSS 8
#define PIN_LORA_SCK 9
#define PIN_LORA_MOSI 10
#define PIN_LORA_MISO 11
#define PIN_LORA_RST 12
#define PIN_LORA_BUSY 13
#define PIN_LORA_DIO1 14

// --- Mesure de la tension de batterie ---
#define PIN_BAT_ADC 1
#define PIN_BAT_CTRL 37

// --- Ajouts du projet, hors carte ---
//
// Heltec documente les GPIO utilisables pour du matériel externe sur la V3 :
//   GPIO 1, 2, 4, 5, 6, 7, 19, 20, 47, 48
// dont ADC1 = GPIO 1 à 7, et ADC2 = GPIO 19 et 20. ADC2 est réquisitionné dès
// que la radio Wi-Fi s'active : on reste donc sur ADC1. GPIO 1 sert déjà à la
// mesure de batterie, d'où 6 et 7.
//
// À éviter absolument sur cette carte : les broches de strapping (échec de
// démarrage), GPIO 21 (reset de l'OLED), GPIO 43 et 44 (USB série), GPIO 39
// à 42 (JTAG).
//
// Sorties analogiques des sondes d'humidité.
//
// ADC1 laisse quatre broches libres après la mesure de batterie (1) et
// l'alimentation des sondes (6) : 7, 2, 4 et 5. Les trois sondes du POC tiennent
// donc en direct, sans multiplexeur — ce qui est nécessaire pour O3, dont
// l'expérience de divergence serait faussée par les canaux du CD74HC4067. Le
// multiplexeur reste indispensable au-delà de quatre sondes, c'est le sujet
// de O2.
#define PIN_SOIL_SIG 7
#define PIN_SOIL_SIG_2 2
#define PIN_SOIL_SIG_3 4
// GPIO 5 reste libre pour une quatrième sonde en direct.

// Alimentation de la sonde, pilotée par un GPIO pour ne l'allumer que pendant
// la mesure (croquis 06). Une sonde capacitive tire ~5 mA, très en dessous des
// 40 mA qu'un GPIO d'ESP32 peut fournir : pas besoin de transistor au POC.
#define PIN_SOIL_PWR 6

// --- Multiplexeur CD74HC4067, sujet de O2 ---
//
// Un aiguillage : seize entrées, une sortie, et quatre fils d'adresse qui
// disent laquelle des seize est reliée à la sortie. Il franchit la limite des
// quatre entrées analogiques directes.
//
// Les quatre fils d'adresse vont sur des broches SANS ADC (47, 48) ou sur
// ADC2 (19, 20), inutilisables pour mesurer de toute façon puisque ADC2 tombe
// dès que le Wi-Fi s'active. Seul MUX_SIG occupe une broche ADC1 — GPIO 7,
// celle qui portait déjà la sonde unique — parce que c'est la seule qui mesure.
//
// Le multiplexeur libère ainsi PIN_SOIL_SIG_2 (2) et PIN_SOIL_SIG_3 (4) : c'est
// tout l'objet de O2. GPIO 2 sert pendant la validation à lire la sonde du
// canal 0 EN DIRECT, en parallèle de sa lecture à travers le mux — même sonde,
// même terre, même instant. C'est ce qui rend le décalage du mux mesurable
// sans se heurter aux 37 points de reproductibilité entre séances.
#define PIN_MUX_SIG PIN_SOIL_SIG
#define PIN_MUX_S0 47
#define PIN_MUX_S1 48
#define PIN_MUX_S2 19
#define PIN_MUX_S3 20
// ACTIF À L'ÉTAT BAS : digitalWrite(PIN_MUX_EN, LOW) met l'aiguillage en
// service. Piloté plutôt que relié à la masse, pour que O6 puisse mesurer ce
// que coûte de le laisser allumé.
#define PIN_MUX_EN 5
// Lecture directe de comparaison, le temps de valider O2.
#define PIN_SOIL_SIG_DIRECT PIN_SOIL_SIG_2

// Fréquence radio. La carte est vendue 863–928 MHz : il faut imposer 868 MHz,
// le défaut du module pouvant être hors bande européenne.
#define LORA_FREQ_MHZ 868.1
