gfriloux/jardin/(commit log)

2026-08-14 Poser le socle du projet : flake Nix, justfile, direnv
    Un flake unique fournit les quatre chaînes d'outils du projet, pour qu'aucune
    reprise ne commence par une demi-journée d'installation : Node pour la doc,
    PlatformIO pour le firmware, Rust pour le collecteur, OpenSCAD pour la coque.
    Deux subtilités NixOS qui bloquent net et méritent d'être notées :
    - `platformio` et non `platformio-core` : PlatformIO télécharge ses propres
    compilateurs, liés dynamiquement pour une distribution classique, qui
    refusent de démarrer sous NixOS. Le paquet `platformio` de nixpkgs est un
    environnement FHS (bwrap) dans lequel ils fonctionnent.
    - `udev` en buildInputs, parce que la crate `serialp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
2026-08-14 Documenter le projet : Astro Starlight, feuille de route, décisions
    La documentation n'est pas le compte rendu du travail, elle en fait partie :
    sur un projet saisonnier avec des interruptions de plusieurs semaines, c'est la
    seule chose qui empêche de tout reperdre. Un objectif n'est pas tenu tant que sa
    page n'est pas écrite.
    Contenu : le contexte et le glissement d'objectif qui structure tout ("un réseau
    de télémétrie du terrain, dont la première application est les fraisiers", et
    non "des sondes pour mes fraisiers"), la feuille de route O0 à O9, les cinq
    principes d'architecture, le modèle de données, l'inventaire du matériel, huit
    risques identifiés avant déballage, et qua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
2026-08-14 Ajouter le firmware de l'objectif O1 : six croquis ESP32-S3
    Six croquis à faire dans l'ordre, chacun validant une chose et une seule, du
    clignotement de LED à la mesure d'humidité :
    01-blink la chaine compile -> televerse -> parle
    02-oled le brochage I2C de l'ecran et Vext
    03-radio le bus SPI vers le SX1262, sans emettre
    04-sonde premiere lecture ADC
    05-caracterisation moyenne, ecart-type, dynamique air/eau
    06-alim-a-la-demande temps de stabilisation de la sonde
    Tout le brochage est centralisé dans include/board.h, et nulle part ailleurs :
    la carte est un clone Heemol de Heltec V3, dont le brochage reste à confirmer.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
2026-08-14 Intégrer la coque de protection des sondes
    Modèle paramétrique OpenSCAD protégeant la partie haute des sondes capacitives
    v1.2 en extérieur. Le .scad est la source de vérité, les STL sont générés par
    `just coque-stl` et jamais versionnés — d'autant que ceux produits jusqu'ici
    l'ont été avec des cotes devinées.
    La contrainte qui gouverne toute la pièce : ne surtout pas enfermer la sonde
    entière. La partie basse est l'électrode capacitive, la mesure se fait à travers
    le vernis du PCB, et 2 mm de plastique plus une lame d'air feraient chuter la
    sensibilité à presque rien. La coque s'arrête donc à 45 mm.
    Trois versions de conception, chacune corrigeant un défaut préci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
    [coque.scad]
2026-08-14 Ajouter la stack serveur : MariaDB, Grafana, schéma SQL
    Un compose.yaml unique, portable : le même fichier doit tourner sur le poste de
    développement aujourd'hui et sur un Raspberry Pi cet hiver. Le choix de la
    machine devient une question d'exploitation, plus une question d'architecture.
    Le schéma sépare trois objets qu'on confond spontanément :
    node une carte LoRa
    sensor une sonde, l'objet qu'on tient dans la main et qu'on étiquette
    channel une prise. 'soil-01' n'est pas une sonde
    NODE-001/soil-01 et NODE-002/soil-01 sont deux prises différentes, et la même
    sonde passe de l'une à l'autre. D'où des tables de liaison datées, et des
    tables de faits qui ne référen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
2026-08-14 Ajouter l'outil de fond de plan cadastral
    Récupère le contour d'une parcelle en vecteur via l'API carto de l'IGN, plutôt
    qu'en capture d'écran : pas de limite de zoom, et on peut le faire pivoter.
    Le nord en haut est une convention de cartographie, pas une contrainte. L'outil
    aligne par défaut l'axe X sur la plus longue limite du terrain, ce qui donne un
    plan où tout est droit et des coordonnées qu'on lit sans transposer.
    Il vérifie sa propre conversion en comparant la surface calculée à la contenance
    cadastrale.
    Le SVG produit ne contient que des mètres relatifs à un coin du terrain : aucune
    latitude, aucune longitude. Le plan est donc publiable sans révéler où se trouve
    l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
2026-08-14 Ajouter un simulateur de nœud, pour éprouver la chaîne sans matériel
    Écrit avant le collecteur, et volontairement : il permet de prouver toute la
    partie serveur avec des données synthétiques. Le jour où le matériel arrive, ce
    qui casse est alors forcément le matériel ou le firmware — on ne débogue plus
    deux inconnues à la fois avec une carte neuve dans les mains.
    Deux sorties, correspondant à deux points de la chaîne : un pseudo-terminal que
    le collecteur ouvrira comme un vrai port série, et l'archive NDJSON directement,
    pour fabriquer un historique instantanément.
    Le modèle de sol reproduit ce qu'on cherchera réellement à observer, plutôt que
    des nombres au hasard :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
2026-08-14 Écrire le collecteur : série vers archive, archive vers MariaDB
    Un binaire, deux sous-commandes, deux responsabilités qui ne se mélangent
    jamais. `collect` ne connaît pas SQL, `import` ne connaît pas le port série, et
    la seule chose qui les relie est un répertoire de fichiers texte.
    collect ne comprend pas ce qu'il transporte
    -------------------------------------------
    Il valide que la ligne est du JSON, en extrait frame.node pour choisir le
    fichier, et recopie tout le reste sans l'interpréter. Le jour où le firmware
    ajoutera un champ, il traversera l'archive intact au lieu d'être silencieusement
    perdu. Les entiers restent entiers : 1834, jamais 1834.0.
    Le nom du nœud est filtr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
    [collect.rs, frame.rs, import.rs, main.rs]
2026-08-14 Provisionner le tableau de bord Grafana
    Six panneaux, chacun répondant à la question d'un objectif plutôt qu'à
    « montrer les données » : état des nœuds, valeur brute d'ADC, humidité
    calibrée, écart entre sondes de même profondeur, qualité du lien radio,
    tension d'alimentation.
    Provisionné par fichier, donc versionné et présent au premier démarrage sans
    rien cliquer. L'interface ne peut pas écraser le fichier : « Save as » sert à
    expérimenter, et ce qui mérite d'être gardé se reporte dans le JSON.
    Deux points de conception :
    - l'écart entre sondes est calculé PAR PROFONDEUR. Comparer une sonde à 10 cm
    et une à 20 cm n'aurait aucun sens : ce qui reste après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
2026-08-14 Refuser de téléverser quand aucune carte n'est branchée
    Sans carte sur un port USB, PlatformIO se rabattait sur le premier port série
    venu — /dev/ttyS0, celui de la carte mère — et tentait d'y écrire un firmware
    ESP32. L'erreur produite parle de permissions et suggère d'ajouter l'utilisateur
    au groupe dialout, ce qui envoie chercher au mauvais endroit : le vrai problème
    est qu'il n'y a pas de carte.
    `just fw` cherche désormais explicitement un /dev/ttyUSB* ou /dev/ttyACM*, passe
    le port trouvé à PlatformIO, et refuse de démarrer sinon en listant les causes
    plausibles — carte non branchée, câble sans fils de données, confusion avec le
    port série de la carte mère.
    Docu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
2026-08-14 Épingler la plateforme ESP32 et les bibliothèques du firmware
    Le firmware était la seule partie du projet à dépendre de versions flottantes,
    alors que nixpkgs, npm, Cargo et les images de la stack sont tous verrouillés.
    PlatformIO n'a pas de fichier de verrouillage : platformio.ini est le verrou. Un
    `platform = espressif32` sans version saute silencieusement à la suivante dès
    qu'Espressif publie, emportant avec elle le cœur Arduino et toute la chaîne de
    compilation.
    Sur une carte qui est déjà un clone au brochage à confirmer, c'est le pire
    moment pour qu'un croquis cesse de fonctionner sans raison visible : on
    soupçonnerait le matériel. Relever une version devient un acte vo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
2026-08-15 Outiller la mesure : enregistrement, analyse, diagnostic USB
    `just fw-log <croquis> <étiquette>` double le moniteur série dans
    mesures/. Une caractérisation qu'on ne peut pas relire est une
    caractérisation à refaire : le terminal tronque, et on ne remontera pas
    le même montage pour retrouver un chiffre.
    tools/analyse-mesures.py dépouille ces journaux. Il comprend les deux
    formats du firmware, sépare les paliers d'un relevé brut, et distingue
    les deux régimes d'écart-type observés — des séries calmes à 1-5 points
    alternent avec des séries agitées à 9-17, sans population intermédiaire.
    En faire une moyenne unique ne décrirait ni l'un ni l'autre.
    Le .gitignore excluait ce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
2026-08-15 Ajouter 04b-sonde-diag, qui dit pourquoi une sonde reste muette
    Une lecture d'ADC proche de zéro ne dit pas si le capteur est mort, si
    la broche flotte, ou si un fil ne tient pas. Ce croquis lit GPIO 7 en
    flottant puis avec les résistances internes de tirage haut et bas : une
    sortie alimentée est de basse impédance et leur résiste, une broche
    libre les suit d'un bout à l'autre de la plage.
    Il distingue trois cas — broche libre, contact intermittent, broche
    tenue à la masse — et donne pour chacun quoi vérifier, dans l'ordre de
    probabilité. Le dernier cas propose une bissection : débrancher AOUT du
    seul côté de la sonde sépare un court-circuit de câblage d'une sonde
    défaill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
2026-08-15 Documenter O1 : la sonde est caractérisée, le brochage confirmé
    O1 passe à « tenu ». Les quatre croquis de validation passent sur la
    carte réelle, et le clone Heemol suit le brochage Heltec V3 sans un seul
    écart : board.h n'a demandé aucune correction. C'était le risque numéro
    un du projet.
    Les six états mesurés, en points d'ADC :
    air libre 2683,9 0,0 %
    terre sèche 2680,3 0,2 %
    essuie-tout humide 2299,4 25,7 %
    terre humide 1411,5 85,2 %
    terre saturée 1199,4 99,4 %
    immersion 1189,7 100,0 %
    Dynamique de travail : 1481 points entre sol sec et sol saturé. La
    résolution n'est pas le facteur limitant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
2026-08-15 Convertir o1-05 en JPEG et fixer la règle de format des photos
    Le PNG pesait 3,8 Mo pour une photo d'appareil. En JPEG qualité 90 il
    tombe à 584 Ko, sans différence visible — la sérigraphie du capteur et
    les repères de composants restent lisibles, ce qui est la seule chose
    que cette image doit montrer.
    Le format n'est pas indifférent : PNG stocke chaque pixel sans perte, ce
    qui convient au trait net d'une capture d'écran mais coûte six à dix
    fois plus cher sur le bruit de capteur d'une photo. Et git conserve
    chaque version d'un binaire pour toujours, donc un PNG déposé par erreur
    reste dans l'historique après correction. Sur la trentaine de photos que
    prévoit materiel/photos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
2026-08-15 Sortir O3 de la dépendance au multiplexeur
    O3 attendait O2, donc le CD74HC4067, dont la livraison n'a toujours pas
    de date. Or ADC1 laisse quatre broches libres une fois la mesure de
    batterie (GPIO 1) et l'alimentation des sondes (GPIO 6) câblées : 7, 2,
    4 et 5. Les trois sondes du POC tiennent en direct.
    Le câblage direct n'est pas un contournement, c'est le bon montage pour
    cette expérience. Mesurer la divergence à travers un multiplexeur ne
    permettrait plus de distinguer la dispersion des sondes de celle des
    canaux, qui ont leur propre résistance à l'état passant. La question que
    O3 pose exige d'isoler les sondes.
    L'ordre inversé rend en outre O2 vérifiable. Son critère de s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
2026-08-15 Consigner l'écart soupçonné sur enc_y, avant toute impression
    La cote est estimée à 34 mm dans coque.scad, et notée « au jugé ». La
    photo o1-05, en prenant la pièce de 2 € comme étalon, situe l'encoche
    vers 19–21 mm du bord haut du PCB.
    L'estimation vaut ce que vaut une photogrammétrie sur photo de
    téléphone — la sonde y mesure 111 mm à l'échelle de la pièce alors que
    ces modules en font 98, soit 13 % d'erreur de perspective, corrigée mais
    pas éliminée. Ce qui survit à l'incertitude, c'est l'ordre de grandeur
    de l'écart : une douzaine de millimètres.
    Or enc_y est une position, pas un jeu : fausse de plus d'un millimètre,
    la carte ne se pose pas à plat et la c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
2026-08-15 Détailler le câblage des trois sondes sur la breadboard
    La page O3 ne montrait le montage qu'en abstrait — quelle broche va où —
    sans dire comment ça se traduit en trous de breadboard. C'est le genre
    d'écart qui bloque quelqu'un qui n'a jamais utilisé l'objet.
    GND et VCC sont communs aux trois sondes et vont dans les rails, qui
    sont faits pour ça. AOUT ne l'est pas : trois lignes distinctes, sinon
    les sondes sont court-circuitées entre elles et renvoient toutes la même
    valeur — ce qui ressemblerait à trois sondes parfaitement accordées,
    soit exactement le contraire du résultat que O3 cherche à établir.
    Signale surtout que le rail d'alimentation porte GPIO 6 et non du 3V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
2026-08-15 Faire téléverser `fw-log`, qui n'ouvrait que le moniteur
    La recette annonçait « la même chose que fw, mais enregistrée ». Elle
    n'appelait jamais `pio run -t upload` : elle branchait le moniteur sur
    la carte telle qu'elle était.
    Le résultat est le pire genre de panne. Demander
    `fw-log 07-trois-sondes` enregistrait la sortie du croquis flashé la
    fois d'avant, dans un fichier nommé d'après le croquis demandé. Un
    journal faux, portant un nom juste, et que rien ne signale — jusqu'à ce
    qu'on relise les chiffres six mois plus tard.
    Ajoute un en-tête au journal : croquis, étiquette, horodatage ISO. Si la
    sortie enregistrée ne ressemble pas au croquis annoncé, c'est que le
    tél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
2026-08-15 Recadrer O3 : on détecte un seuil, on ne mesure pas une humidité
    Deux décisions de scope, ADR-015 et ADR-016, et leurs conséquences sur
    la page O3.
    ADR-015. La caractérisation de O1 a produit des chiffres flatteurs, et
    avec eux la tentation de raffiner : étalonner chaque sonde, mesurer le
    décalage des canaux d'ADC, imposer une profondeur de pose au
    millimètre. Cette tentation confond la qualité de l'instrument avec le
    besoin. Le système répond à une question binaire — faut-il arroser — et
    le seuil se découvrira en regardant sécher le sol réel, pas en raffinant
    l'électronique sur une table.
    Ce qui disparaît : l'étalonnage par sonde, la mesure du décalage des
    canaux, l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
2026-08-15 Renommer les journaux de mesure qui mentaient sur leur contenu
    Trois fichiers portaient une étiquette fausse, et je les ai committés
    sans les ouvrir au coup d'avant.
    Les deux de 20h44 et 20h45 s'annonçaient « 07-trois-sondes » et
    contiennent la sortie de 06-alim-a-la-demande : ce sont les captures
    faites avant que `fw-log` téléverse, c'est-à-dire les pièces à
    conviction du défaut qu'elles ont révélé. Renommés d'après leur contenu
    réel, ils gardent cette valeur-là.
    Celui de 21h14 s'annonçait « meme-pot » et contient la mesure dans le
    verre d'eau — la commande avait été rejouée telle quelle. L'en-tête
    généré ne protège que du mauvais croquis, pas de la mauvaise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
2026-08-15 Interdire les identifiants cadastraux dans le dépôt
    Code INSEE, section et numéro de parcelle désignent exactement un
    terrain, et l'API carto de l'IGN est ouverte à tous. Les inscrire dans
    la documentation revient à publier son adresse.
    Ils figuraient en clair dans l'exemple d'appel de plan-parcelle.py, dans
    son en-tête d'aide, et dans trois libellés de la page. La même page
    affirmait onze lignes plus bas que le plan « peut être publié sans
    révéler où se trouve le jardin » : vrai du SVG, faux de la page qui le
    contient.
    Les exemples portent désormais des marqueurs. Les identifiants réels se
    passent en ligne de commande, une fois, au moment de générer le SVG.
    L'historiq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
2026-08-15 Placer le dépôt sous Apache 2.0
    Un dépôt public sans licence est en « tous droits réservés » : personne
    ne peut légalement le réutiliser, alors que la visibilité suggère le
    contraire.
    Apache 2.0 plutôt que MIT pour deux clauses que MIT n'a pas. La
    concession de brevet explicite protège les utilisateurs contre un
    contributeur qui viendrait ensuite faire valoir un brevet sur ce qu'il a
    lui-même apporté — utile sur un projet qui touche au matériel.
    L'obligation de signaler les modifications garde traçable ce qui a été
    changé, ce qui compte quand les valeurs publiées sont des mesures.
    Le texte vient de l'API GitHub, vérifié identique à l'octet près hors la
    ligne de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
2026-08-15 Clore O3 : les sondes sont interchangeables
    L'écart maximal entre les trois sondes est de 7,8 points, mesuré dans
    deux milieux — soit 0,5 % de la dynamique utile et un cinquième de
    l'incertitude entre séances. Le critère de sortie est atteint.
    Note dans les résultats que ce critère a été révisé après la mesure. Il
    demandait une courbe de référence par sonde ; la divergence s'est
    révélée négligeable, puis l'ADR-015 a retiré l'exigence, dans cet ordre.
    Le raisonnement de l'ADR tient indépendamment du résultat — on ne
    calibre pas finement un système qui décide en binaire — mais la
    chronologie est écrite pour qu'on puisse en juger.
    Déplace les deux questions qui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
2026-08-15 Verser les deux photos de l'atelier coque
    La `o1-10` est la sonde posée sur un réglet, dans le même plan que les
    graduations. C'est ce qui la sépare de la `o1-05`, où la pièce de 2 €
    servait d'étalon à côté de l'objet : là, l'étalon et l'objet sont à la
    même distance de l'objectif, et l'encoche se lit au dixième au lieu de
    « quelque part entre 19 et 21 ».
    La `o1-13` montre la coquille v4 telle qu'elle sort de l'imprimante,
    à côté de la carte qu'elle refuse d'accueillir.
    Les deux sont converties en JPEG et dépouillées de leur EXIF, comme la
    page des photos le demande.
2026-08-15 Poser les ergots de la coque là où sont vraiment les encoches
    La v4 a été imprimée. Elle sort propre, elle se ferme, et la carte
    n'entre pas. Un seul défaut, celui qui était soupçonné : `enc_y` était
    estimé à 34 mm et vaut 19. Les ergots tombaient 15 mm trop bas, la carte
    se posait dessus au lieu de s'asseoir dedans.
    Le relevé au réglet donne l'encoche entre 17,2 et 20,7 mm du bord haut,
    soit un centre à 18,95 ; la lecture directe du bord donne 18, soit un
    centre à 19,8. La valeur retenue, 19,4, est à moins de 0,45 mm des deux.
    La photo apprend aussi la forme : l'encoche est un demi-cercle de
    3,55 mm, pas un rectangle. L'ergot rectangulaire de la v4 (3,4 × 1,2)
    n'y serait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
    [coque.scad]
2026-08-15 Raconter la v5 de la coque et le relevé qui l'a décidée
    La page annonçait sept cotes estimées et interdisait d'imprimer. La
    situation a changé : la v4 est imprimée, le défaut est identifié, la
    cote est relevée. La page le dit maintenant dans cet ordre.
    Ajoute la section v5 — position corrigée et ergot rond —, la section
    « Le relevé qui a tranché » avec le tableau des distances lues au
    réglet, et la sortie de `just coque-test` telle qu'elle s'affiche.
    Tranche au passage la question laissée ouverte sur `pcb_in` : à 19 mm du
    bord haut, l'encoche ne peut pas être le repère d'enfoncement maximal,
    ce serait enterrer la carte jusqu'au connecteur. Le candidat est le
    trait b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
2026-08-15 Corriger enc_y de 0,5 mm : ma photogrammétrie mesurait 5 % trop court
    Le relevé du trait blanc au réglet, 26 mm, contredisait mes 24,7. La
    même contradiction existait sur l'encoche, 18 contre 17,2. Deux écarts
    proportionnels à la distance, pas constants : c'est une erreur
    d'échelle, pas une erreur de lecture.
    La cause est géométrique. La carte est plus haut dans le cadre que les
    graduations qui servent d'étalon, donc plus loin de l'objectif, donc
    reproduite plus petite. Calibrer sur les graduations et mesurer sur la
    carte revient à mélanger deux échelles.
    La parade est de ne mesurer que des rapports. Le coin haut, l'encoche et
    le trait blanc sont alignés sur le même chant :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
    [coque.scad]
2026-08-15 Reporter à O7 la profondeur d'enfoncement, et le dire
    La coque engage 48 mm, soit 22 mm sous la limite d'immersion : elle
    plafonne l'enfoncement à 50 mm d'électrode dans le sol là où la carte en
    autorise 72. Descendre `pcb_in` à ~30 mm les rendrait, au prix d'une
    refonte des proportions du boîtier.
    Ce n'est pas le moment. La v5 corrige un seul défaut, et c'est ce qu'il
    faut pour savoir s'il est corrigé : raccourcir le corps en même temps
    changerait H, la position des vis, la jupe et le col, et une impression
    ratée ne dirait plus laquelle des deux modifications a échoué.
    Surtout, la question n'est pas géométrique. Savoir si 50 mm de sonde en
    terre suffisent, ou si les valeurs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
    [coque.scad]
2026-08-15 Fixer enc_diam à 4 mm, mesuré au lieu de calculé
    La mesure directe donne 4,0 pour le diamètre de l'encoche, là où le
    rapport d'image donnait 3,77. C'est le rapport qui a tort, et pour une
    raison qui vaut d'être retenue : le flou de bord coûte environ deux
    pixels à chaque extrémité d'un repère. Sur les 500 px qui séparent le
    coin haut du trait blanc, ça fait 0,8 % — invisible. Sur les 73 px de
    l'encoche, 5,5 % — soit exactement l'écart constaté.
    Un rapport mesuré sur une image mesure les longs écarts, jamais les
    petits détails. Le grand écart calibre, le petit détail se mesure à la
    main.
    Le début de l'encoche restant lu à 18,0, le centre passe à 20,0 et la
    tolé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
    [coque.scad]
2026-08-16 Verser les photos de la v5 montée
    La `o1-15` montre la carte encastrée dans la coquille avant imprimée,
    ergots dans les encoches : le défaut de la v4 est corrigé pour de bon,
    et cette fois sur la pièce plutôt que dans le modèle.
    La `o1-16` ajoute le câble branché. Le col de cygne fait ce qu'on lui
    demandait depuis la v2 : le connecteur reste dedans, le câble se couche
    dans le conduit sans rien à enfiler, et il ressort par le bas.
    La `o1-15` dit aussi quelque chose que personne n'avait demandé : on n'y
    voit que deux trous de vis. Les deux autres sont sous la carte.
2026-08-16 Fermer la coque : rainure et languette, écrous noyés, rien de traversant
    Trois défauts, que le montage de la v5 sur la table a rendus visibles
    d'un coup.
    La coquille arrière était un couvercle plat : l'avant portait une gorge
    à silicone, l'arrière rien. Les deux pièces se posaient l'une sur
    l'autre au lieu de s'emboîter. L'arrière porte maintenant une languette
    0,6 × 0,6 qui entre dans une rainure 1,0 × 0,9. Le silicone occupe le
    jeu qui reste — 0,2 par côté, 0,3 de fond — et se trouve contenu de
    trois côtés au lieu d'être écrasé entre deux plats.
    Les vis n'avaient de logement ni pour la tête ni pour l'écrou. Un écrou
    M3 se noie désormais dans un hexagone du plan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
    [coque.scad]
2026-08-16 Documenter la v6, et ce que le montage sur table a appris
    La page racontait la conception jusqu'à la v5 et s'arrêtait sur une cote
    à relever. Elle raconte maintenant la suite : la v5 imprimée, la carte
    qui s'encastre, et les trois défauts que seule la pièce en main pouvait
    montrer.
    Ajoute la section v6 avec le schéma en coupe du joint, remplace les
    rendus, et met la quincaillerie à jour partout où elle était écrite —
    page de la coque, README du modèle, inventaire. M3×8 tête fraisée et
    écrous M3 au lieu de M3×12.
    Le pied à coulisse ne sert plus qu'à trois cotes de jeu, plus aux sept
    d'origine : l'inventaire le disait encore.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
2026-08-16 Retourner la coquille arrière par une rotation, pas par un miroir
    La v6 imprimée sortait inutilisable : languette et fraisures toutes les
    deux du mauvais côté. La vue d'assemblage était pourtant juste, et les
    quatre contrôles passaient. Le défaut n'était pas dans la pièce, il
    était dans le geste qui l'amène à sa place.
    Le modèle posait la coquille arrière sur l'avant par mirror([0,0,1]). On
    ne retourne pas une pièce réelle par une symétrie, seulement par une
    rotation — et une rotation de 180° inverse deux axes, pas un seul. Le
    contour n'étant symétrique ni en x ni en y, col d'un côté et jupe de
    l'autre, la pièce exportée n'atteignait sa pose d'assemblage par aucun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
    [coque.scad]
2026-08-16 Dégager les soudures du connecteur, que la coquille arrière écrasait
    Le connecteur est traversant : ses trois soudures dépassent au dos de la
    carte, côté couvercle, et rien dans le modèle ne représentait le PCB
    autrement que comme une plaque lisse. Sans dégagement, 19,34 mm³ de
    soudure sont enfouis dans le plastique — la coque ne ferme pas.
    Relevé sur pièce : 2,0 mm de haut. Le rang est à 4,5 mm sous le bord
    haut de la carte, au pas de 2,54 — un pas au pouce, et non les 2,0 d'un
    PH2.0 comme l'en-tête du modèle le supposait.
    Ce qu'il faut dégager n'est pas 2 mm. La carte s'assoit déjà 0,3 sous le
    plan de joint, son logement étant creusé d'autant en plus ; la saillie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
    [coque.scad]
2026-08-18 Raccourcir la coque de 18 mm, rendus au sol
    La coque engageait 48 mm de carte quand le dernier composant est à
    24,4 mm du bord haut et le trait d'immersion à 26,0. Elle couvrait donc
    22 mm d'électrode sans avoir à le faire — et chaque millimètre couvert
    est un millimètre qui ne lit pas le sol. La carte autorise 72 mm
    d'enfoncement, la coque en laissait 50, elle en laisse maintenant 68.
    `pcb_in` passe à 30, soit 4 mm sous le trait. Le corps suit, de 52 à 34,
    et avec lui le col de cygne et les vis hautes. Ces cotes deviennent
    dérivées — H = pcb_in + 4, y_haut = H + 4, vis à H − 8 — parce qu'une
    hauteur posée à la main à cinq endroits n'est plus une hauteur, c'est
    cinq oc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
    [coque.scad]
2026-08-18 Clore la géométrie de la coque : la v9 est validée au montage
    Cinq versions imprimées, chacune corrigée sur un défaut que la
    précédente ne pouvait pas montrer — la carte qui n'entre pas, les deux
    vis sous la carte, la coquille arrière qu'aucun mouvement réel n'amenait
    à sa place, les soudures du connecteur, les 18 mm d'électrode couverts
    pour rien. Aucun de ces défauts n'était visible à l'écran, et c'est le
    vrai enseignement de la série.
    La page d'état passe donc du récit chronologique à un tableau : ce que
    chaque impression a appris, le cheminement pour le détail. Le badge, le
    README du modèle et la page des risques suivent.
    Ce qui reste à prouver n'est plus la fo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
2026-08-18 Verser les photos de la coque montée
    La `o7-06` montre la coquille avant de l'assemblage v9, et ce qu'on n'y
    voit pas est le résultat le plus important de la série : aucun perçage.
    Jusqu'à la v5, quatre avant-trous traversaient cette face de part en
    part, à l'intérieur du cordon de joint. La face est maintenant pleine.
    La `o7-09` donne l'encombrement réel une fois fermée, et le plan de
    joint vu de profil.
    La `o7-06` était prévue coquilles ouvertes, sonde posée dedans. La
    réalité vaut mieux : la coque est fermée et vissée, donc sa raison
    d'être change et sa ligne aussi.
    Une troisième photo, montrant la face vissée, n'est pas versée : 250 x
    333, trop petite pour servir.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
2026-08-18 Verser la sortie de câble sur l'assemblage final
    La `o7-07` était prévue depuis la rédaction de la liste : « la coque
    fermée, câble sorti par le col de cygne, la sortie vers le bas qui est
    tout l'intérêt du design ». La voici.
    Elle referme le premier défaut relevé sur la v1, quatre versions plus
    tôt : la sortie verticale d'origine était un entonnoir. La bouche
    regarde maintenant vers le bas, 26 mm plus bas que le point haut du
    conduit — pour entrer, l'eau devrait remonter.
2026-08-18 Écrire les deux croquis de O4, émission et réception
    `08-node-emission` lit la sonde, lit la batterie, compose la trame et
    l'émet. C'est le premier croquis du projet qui émet vraiment — 03-radio
    s'arrêtait volontairement au réveil de la puce. Il affiche aussi ce
    qu'il envoie sur la liaison série, ce qui le rend testable seul, sans la
    passerelle.
    `09-gateway-reception` reçoit, ajoute RSSI et SNR, écrit une ligne. Elle
    n'interprète pas la charge utile : elle l'insère telle quelle dans son
    enveloppe, comme le collecteur recopie sans comprendre. Le jour où le
    nœud ajoute un champ, il traverse intact.
    Les paramètres radio sont redits en toutes lettres dans les deux
    fichiers plu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
2026-08-18 Écrire la procédure du premier essai radio dans la page O4
    Trois étapes, chacune ne pouvant échouer que pour une raison : le bus
    SPI du nœud, puis la passerelle en écoute, puis l'émission. Une panne
    au milieu désigne alors sa cause au lieu de laisser trois suspects.
    Y consigne aussi les deux pièges que le code seul ne dit pas assez fort.
    Deux cartes mal accordées restent muettes sans signaler d'erreur : c'est
    les six paramètres radio qu'il faut comparer avant de soupçonner la
    portée ou l'antenne. Et la tension de batterie repose sur trois valeurs
    de la documentation Heltec jamais vérifiées sur notre clone — si le
    chiffre est absurde, la polarité de PIN_BAT_CTRL d'abord, le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
2026-08-19 Dessiner la coque des cartes LoRa, cartes empilées
    Une seule coque pour NODE-001 et GATEWAY-001, les deux cartes portant la
    même rangée de 18 broches soudée : elles restent interchangeables si l'une
    meurt au jardin.
    Trois étages. La carte fille du milieu n'est pas un luxe : les huit broches
    de commande du CD74HC4067 ne tombent jamais en face des bonnes broches
    Heltec, il faut une pièce qui réordonne. Elle se pose sur la rangée par une
    barrette femelle tulipe 1x18 — 18 positions alors que 7 suffisent, les onze
    inutilisées faisant toute la tenue mécanique.
    L'empilage a été préféré à la disposition à plat pour trois raisons : un
    périmètre de joint plus court, un couvercle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
2026-08-19 Monter le banc d'essai de la coque des cartes
    Huit contrôles rendant chacun un volume qui doit être vide, sur le modèle de
    `just coque-test`. Le premier est celui qui compte : la carte fille contre
    l'écran OLED, le mode de panne propre à l'empilage — la coque sort propre,
    se visse, et écrase l'écran.
    Le banc rejoue ensuite chaque contrôle avec son défaut réintroduit et exige
    qu'il morde. C'est ce qui a révélé que le contrôle de visserie ne mesurait
    rien : la position des vis se dérivant de la taille des cartes, elle ne
    pouvait pas tomber dessus. Le contrôle était vrai par construction. D'où
    `vis_marge`, qui n'existe que pour rendre le défaut à nouveau exprimable.
    Co-A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
2026-08-30 Verser les journaux du premier essai radio
    Deux sessions : l'essai de table à un mètre, puis la campagne à 15 m.
    Le premier ne fait que trois trames mais il n'est pas un brouillon : à
    -17/-20 dBm, il donne l'échelle qui rend les -64 dBm du jardin lisibles.
    Sans lui, un journal seul ne dit pas d'où la trame est partie.
2026-08-30 Abaisser le plancher d'émission pour la campagne de portée
    Cent trames par position à 60 s l'une font 1 h 40 par position, ce qui
    condamne la campagne avant qu'elle commence. Le plancher passe à 10 s et
    le calcul de rapport cyclique reprend la main : ~14 s constatés.
    Pas zéro pour autant — le plancher reste un filet contre un
    getTimeOnAir() qui renverrait 0, cas où le nœud émettrait en continu et
    illégalement sans que rien ne le signale.
    À remettre à 60000 une fois la campagne close.
2026-08-30 Consigner les résultats de O4 : le lien porte, avec 60 dB de marge
    0 % de perte sur 170 trames à 15 m, RSSI -64,4 dBm, SNR saturé. Trois
    questions ouvertes se ferment : pas de montée en facteur d'étalement,
    antenne fournie suffisante, et la taille de trame à SF12 devient sans
    objet. O5 n'est plus bloqué.
    Le critère de sortie est ramené au besoin réel — 15 m couvrent les plants
    à surveiller — plutôt que tenu au point le plus éloigné du terrain. C'est
    un rétrécissement assumé, pas un critère atteint.
    Corrige au passage une règle qui était fausse dans le régime mesuré : le
    SNR n'est plus informatif que le RSSI qu'au bord du décrochage, le
    SX1262 saturant vers +13 dB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
2026-08-30 Prouver la saturation du SNR par les mesures plutôt que par la fiche
    Le SNR vaut 12,5 dB à -17 dBm comme à -64,4 dBm : 45 dB d'écart en
    signal, et il ne bouge pas. La note disait « le SX1262 sature vers
    +13 dB » d'après la documentation ; les deux journaux du 30 août le
    montrent directement, ce qui vaut mieux.
    Corrige au passage la provenance du journal de référence : le nœud était
    dans la même pièce que la passerelle, pas « à un mètre », qui était une
    supposition.
2026-08-30 Rafraîchir l'état affiché : quatre objectifs tenus, plus rien en attente
    La page d'accueil annonçait encore « O0 tenu » et du matériel qui arrive
    les 15 et 16 août. Elle est la première chose qu'on lit, et elle datait
    du premier jour du projet.
    Corrige aussi O2, en attente d'un multiplexeur qui est arrivé depuis. Le
    POC n'a plus aucun objectif bloqué : O2 et O5 sont tous deux prêts.
2026-08-30 Poser les badges manquants dans le menu
    O4 n'avait pas reçu son badge « Tenu », alors que O0, O1 et O3 le
    portaient déjà : la convention existait, l'objectif est simplement passé
    au travers.
    Ajoute aussi « Prêt » sur O2 et O5. Sans eux le menu ne distingue pas ce
    qui attend du travail de ce qui attend un objectif amont — or c'est
    justement la question qu'on se pose en ouvrant la page, et les deux sont
    désormais attaquables.
    Les objectifs bloqués restent sans badge : l'absence dit déjà « pas
    encore ».
2026-08-30 Déclarer le référentiel : SOIL-A1 sur NODE-001, zone FRAISIERS
    L'import signalait « nœud NODE-001 inconnu, à déclarer » : les mesures
    arrivaient mais n'étaient rattachées ni à une sonde ni à une zone, ce
    que le critère de sortie de O5 exige.
    Le fichier vit dans docker-entrypoint-initdb.d parce que c'est la seule
    partie de la base qui ne se reconstruit pas depuis l'archive. Ailleurs,
    un db-reset effacerait des déclarations qu'aucun réimport ne pourrait
    rejouer, et les mesures redeviendraient orphelines archive intacte.
    Tout y est idempotent — vérifié en le rejouant trois fois de suite, sans
    duplication. Les liaisons datées n'ont pas de clé unique, l'idempotence
    passe do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
2026-08-30 Remplacer les trois tables de sondes par un point de mesure
    sensor, sensor_attachment et sensor_placement disparaissent au profit
    d'une seule table : une voie d'un nœud, son nom d'affichage, sa zone,
    daté.
    Les sondes capacitives sont interchangeables — O3 a mesuré 7,8 points de
    divergence maximale, et montré que l'écart n'est même pas attribuable
    aux sondes puisque leur classement s'inverse entre deux milieux. Leur
    donner une identité obligeait à les étiqueter au marqueur pour une
    information que personne n'irait lire. On change un pneu sans le
    baptiser.
    Les dates restent, et changent de sens : elles suivent le câblage, pas
    le matériel. Sans elles, déclarer une voie dans une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
2026-08-30 Suivre le renommage dans le tableau de bord
    sensor_uid n'existe plus dans les vues : les trois requêtes affichent
    désormais point_label, le nom d'emplacement.
2026-08-30 Acter l'ADR-017 et corriger le modèle de données
    L'ADR porte l'argument du pneu et, surtout, le contre-argument qui a été
    pesé puis écarté : une sonde neuve remplaçant une sonde vieillie peut
    produire un décrochage franc, et sur une courbe un remplacement
    ressemble à un assèchement brutal. Les 7,8 points de O3 ne couvrent pas
    ce cas, ayant été mesurés entre trois sondes neuves. Mais la date du
    recâblage suffit à l'expliquer, et elle tombe gratuitement de la table —
    on garde le fait utile sans l'objet inutile.
    Corrige au passage le tuple canonique, dont la deuxième colonne
    s'appelait sensor_id alors qu'elle a toujours porté une voie.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
2026-08-30 Réparer le panneau « État des nœuds », que le doublon de seq cassait
    La requête calcule le taux de perte en comparant chaque seq au précédent.
    Elle se gardait du redémarrage du nœud, où seq retombe à 0 et devient
    plus petit que le précédent — mais pas du cas où il est ÉGAL.
    Or c'est exactement ce que produit le doublon de seq:0, systématique à
    chaque mise sous tension : (0 - 0 - 1) sur un INT UNSIGNED déborde par le
    bas, et MariaDB rejette la requête entière. Le panneau n'affichait donc
    pas « aucune donnée » mais une erreur, pour les 341 trames à la fois.
    Forcer l'arithmétique signée corrige les deux cas d'un coup et rend 0,
    qui est la bonne réponse : deux tra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
2026-08-30 Lever le risque du multiplexeur, arrivé depuis
    Trois pages le donnaient encore comme sans date de livraison : la page
    O2, l'inventaire, et la fiche de risque.
    La fiche est conservée plutôt que supprimée, en statut « levé ». Elle
    documente maintenant un pari qui a été gagné : ne rien attendre et
    avancer sur O1 → O4, qui ne passe pas par le multiplexeur. O4 a été tenu
    pendant ce délai — c'est la démonstration qu'ordonner les objectifs par
    dépendance réelle plutôt que par numéro fait gagner du temps.
2026-08-30 Permettre à fw-monitor de viser un port nommé
    Il passait par _fw-port, qui prend la première carte venue. Avec les
    deux cartes branchées, impossible d'écouter la seconde — or c'est
    exactement ce que demande le diagnostic du doublon de seq : voir en même
    temps ce que le nœud émet et ce que la passerelle reçoit.
    Le port reste facultatif : sans argument, le comportement ne change pas.
    À ne pas confondre avec la règle du téléversement, qui elle ne bouge
    pas : écouter deux cartes est sans danger, les flasher toutes les deux
    branchées ne l'est pas.
2026-08-30 Compter les tentatives et non les succès dans seq
    transmit() rend parfois un code d'erreur alors que la trame est bien
    partie — la marge est mince, 128 ms de temps d'antenne pour 136 ms
    d'émission constatés. Le nœud croyait avoir échoué, n'incrémentait pas
    seq, et réémettait le même numéro au cycle suivant.
    Ce qui a tranché est l'écart entre les deux réceptions de seq:0 dans
    l'archive horodatée : 14,1 s, soit exactement un cycle d'émission. Un
    double décodage d'une même transmission tiendrait dans quelques
    millisecondes. Le nœud a donc bien émis deux fois.
    Le défaut est intermittent : deux occurrences sur plusieurs centaines de
    trames, et une session de diagnostic co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
2026-08-30 Remettre le plancher d'émission à 60 s, la campagne étant close
    Il était abaissé à 10 s depuis le 30 août pour que cent trames par
    position prennent 20 minutes au lieu de 1 h 40. O4 est tenu, le
    raisonnement s'inverse à nouveau : le sol bouge à l'échelle de l'heure,
    et émettre toutes les quatorze secondes ne remplirait l'archive que de
    points qui n'apprennent rien.
    Le commentaire garde la trace de l'abaissement et de sa raison, pour que
    la prochaine campagne sache quoi toucher — et qu'elle ne descende jamais
    à zéro, le plancher restant un filet contre un getTimeOnAir() qui
    renverrait 0.
2026-08-30 Détailler le câblage du multiplexeur, broche par broche
    Deux schémas plutôt qu'un : le module vers la carte, puis les sondes
    vers le module. Un seul dessin à onze fils aurait été pire que pas de
    dessin.
    Le bus vers la carte est délibérément plat — chaque broche va en face, à
    la même hauteur, sans un seul croisement. C'est ce qui rend le montage
    vérifiable d'un coup d'œil plutôt que fil par fil.
    Ajoute le fil qui rend O2 mesurable : la sonde 1 est reliée à la fois à
    C0 et à GPIO 2. Le croquis lit alors la même sonde, dans la même terre,
    au même instant, par deux chemins. Sans lui il faudrait comparer aux
    relevés de O3 du 15 août, or la reproductibilité entre séan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
2026-08-30 Écrire 10-mux, le croquis de O2
    Il répond aux trois questions de l'objectif en une exécution, et par la
    mesure plutôt que par la fiche technique : le décalage introduit par le
    multiplexeur, le délai nécessaire après un changement de canal, et la
    diaphonie entre canaux.
    Le décalage se mesure par le fil qui double la sonde du canal 0 —
    direct sur GPIO 2 et via le mux sur GPIO 7, à quelques millisecondes
    d'intervalle. Le verdict se lit contre les 7,8 points de divergence
    inter-sondes de O3 : un mux qui décale moins que ça décale moins que le
    matériel qu'il dessert.
    La diaphonie se teste en basculant depuis le canal le plus contrasté
    vers le canal visé, dans les deux sens, po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
2026-08-30 Faire refuser 10-mux de mesurer un montage muet
    Premier essai sur matériel : le croquis a annoncé « écart moyen :
    -2316,4 points » avec l'aplomb d'une mesure, alors que le module ne
    commutait pas. Un résultat faux qui a l'air d'un résultat coûte plus
    cher qu'une panne franche.
    Deux contrôles suffisaient, et les données les portaient déjà.
    Un canal câblé qui lit comme le canal 15 non câblé ne reçoit rien : les
    canaux 1 et 2 donnaient 81 et 74 contre 92 pour l'entrée en l'air, alors
    qu'une sonde dans l'eau donne ~875 et à l'air ~2600.
    Et une sortie qui flotte rend une valeur différente selon le canal d'où
    l'on vient, parce qu'elle dépend de la charge résiduelle : le c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
2026-08-30 Crier le piège de EN, que le tableau se contentait de mentionner
    EN branché sur 3V3 au premier montage : la broche étant active à l'état
    bas, le multiplexeur était inhibé et rendait des valeurs qui avaient
    l'air de mesures. Le tableau le disait déjà, en fin de ligne, dans une
    colonne « rôle » — trop discret pour une erreur qui ne ressemble pas à
    une panne.
    Ajoute aussi que les VCC des sondes vont sur GPIO 6 et pas sur 3V3. Sur
    3V3 elles marcheraient, mais resteraient allumées en permanence, ce qui
    annule l'alimentation à la demande mise en place en O1.
2026-08-30 Ramener l'avertissement sur EN à sa règle
    Il avait grossi à chaque erreur rencontrée jusqu'à empiler deux
    explications narratives dans un même encadré, et devenait illisible.
    Reste ce qui sert au montage : en service à 0 V, inhibé à 3,3 V, donc
    sur GPIO 5 et ni sur 3V3 ni sur GPIO 6. Le diagnostic imprimé par le
    croquis passe de neuf lignes à quatre.
2026-08-30 Balayer les seize canaux, pour éprouver S2 et S3
    Trois sondes sur C0, C1 et C2 n'emploient que S0 et S1 : les deux autres
    fils d'adresse n'ont jamais rien commuté. Or c'est S2 qui donne accès au
    canal 4 et S3 au canal 8 — et franchir la limite de quatre entrées est
    toute la raison d'être de O2. La promesse centrale de l'objectif n'était
    donc pas démontrée.
    Lire le canal 15 ne suffisait pas : si S2 et S3 restaient bas, 1111
    sélectionnerait 0011, le canal 3, non câblé lui aussi et rendant la même
    valeur de fond. Les deux cas sont indiscernables.
    Le balayage affiche les seize canaux et pointe celui où une sonde
    répond. Déplacer une sonde sur C4 valide S2, sur C8 valide S3.
    G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
2026-08-30 Empêcher 10-mux de mesurer quand la sonde témoin a bougé
    Deuxième fois que le croquis annonce un décalage inventé avec la mise en
    page d'un résultat : -865 points, parce que la sonde lue par GPIO 2
    avait été déplacée sur C4 pour éprouver S2, pendant que le bloc de
    comparaison continuait d'interroger C0, désormais en l'air.
    Le contrôle ajouté au commit précédent vérifiait que le montage n'était
    pas muet, pas que la sonde témoin était encore là où on la croit.
    Désormais, si direct et C0 s'écartent de plus de 20 %, le bloc dit
    pourquoi il ne conclut pas.
    Le test de diaphonie ne retient plus que les canaux portant réellement
    une sonde. Il avait choisi C0, vide, comme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
2026-08-30 Distinguer une sonde d'un fil en l'air par la stabilité, pas par le seuil
    Le test de diaphonie a retenu le canal 0, vide, comme extrémité basse :
    il avait été lu à 734 en phase de référence, au-dessus du seuil de 300.
    Le même canal donnait 91 au balayage, puis 139 et 1394 dans le suivi
    continu de la même exécution.
    Une entrée en l'air se charge et peut passer n'importe quel seuil. Ce
    qui la trahit est qu'elle ne retrouve pas sa valeur : le croquis lit
    donc chaque canal, passe par un autre, et relit. Une sonde redonne la
    même valeur, un fil en l'air non.
2026-08-30 Clore O2 : seize canaux adressables, multiplexeur transparent
    Quatre résultats, tous mesurés plutôt que lus dans une fiche technique.
    Le multiplexeur décale de 1,7 point dans l'air et 0,5 dans l'eau —
    proportionnellement au signal, ce qu'on attend d'une résistance à l'état
    passant. Vingt fois moins que les 37 points de reproductibilité entre
    séances : il disparaît sous tout le reste.
    Aucun délai n'est nécessaire après un changement de canal, et aucune
    lecture ne porte la trace de la précédente, sur 1484 points de
    contraste. C'était le point de vigilance principal de l'objectif, et le
    seul des quatre résultats qui n'était pas acquis d'avance.
    Les seize canaux sont adres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
2026-08-30 Retirer la semaine d'attente du critère de O5
    Le critère demandait « une semaine de mesures visible dans Grafana ».
    Formulé avant que la chaîne existe, il servait de preuve indirecte que
    tout tenait ensemble. Maintenant que tout a tourné, il ne prouve plus
    grand-chose et coûte sept jours de PC allumé.
    Ce que la semaine apportait ne vaut pas son prix : la tenue du
    collecteur dans la durée se voit en 48 h, la bascule de fichier
    d'archive au changement de mois arrive de toute façon, et le volume ne
    fait rien à MariaDB.
    Ce qu'elle n'apportait pas est précisément ce que O5 cherche. Les sondes
    sont sur une table, l'une dans un verre d'eau : une semaine de ça produit
    une ligne plat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
2026-08-30 Coudre O2 et O4 : le nœud émet ses trois sondes via le multiplexeur
    11-node-mux remplace 08-node-emission, devenu incompatible avec le
    câblage : celui-ci lit une sonde en direct sur GPIO 7, or GPIO 7 porte
    maintenant la sortie du multiplexeur. Le flasher tel quel laisserait EN
    en l'air, donc le mux inhibé, et ferait émettre des valeurs flottantes
    qui ressemblent à des mesures.
    Les deux moitiés sont éprouvées séparément — la séquence de mesure vient
    de 10-mux, l'émission et le garde-fou de rapport cyclique de
    08-node-emission. Aucun délai après changement de canal, comme O2 l'a
    mesuré sur 1484 points de contraste, et seq compte les tentatives comme
    O4 l'a imposé.
    Les sond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
2026-08-30 Rattraper la doc restée sur la semaine d'attente et l'ancien schéma
    Trois pages annonçaient encore « une semaine de mesures » pour O5, alors
    que le critère l'a abandonnée cet après-midi : la page d'accueil, la
    feuille de route, et le contrôle de fin d'objectif de O5.
    Ce dernier affichait en prime une sortie de db-wiring d'avant l'ADR-017,
    avec sensor_uid et des SOIL-A1 qui n'existent plus. Remplacé par la
    sortie réelle, à trois voies.
    Marque aussi 08-node-emission comme dépassé dans platformio.ini. Il
    reste la référence de la campagne de portée de O4, mais le flasher sur
    le câblage actuel laisserait EN en l'air et ferait émettre des valeurs
    flottantes.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
